chalos18/PROD385Project/images/climbing_wall.JPEG

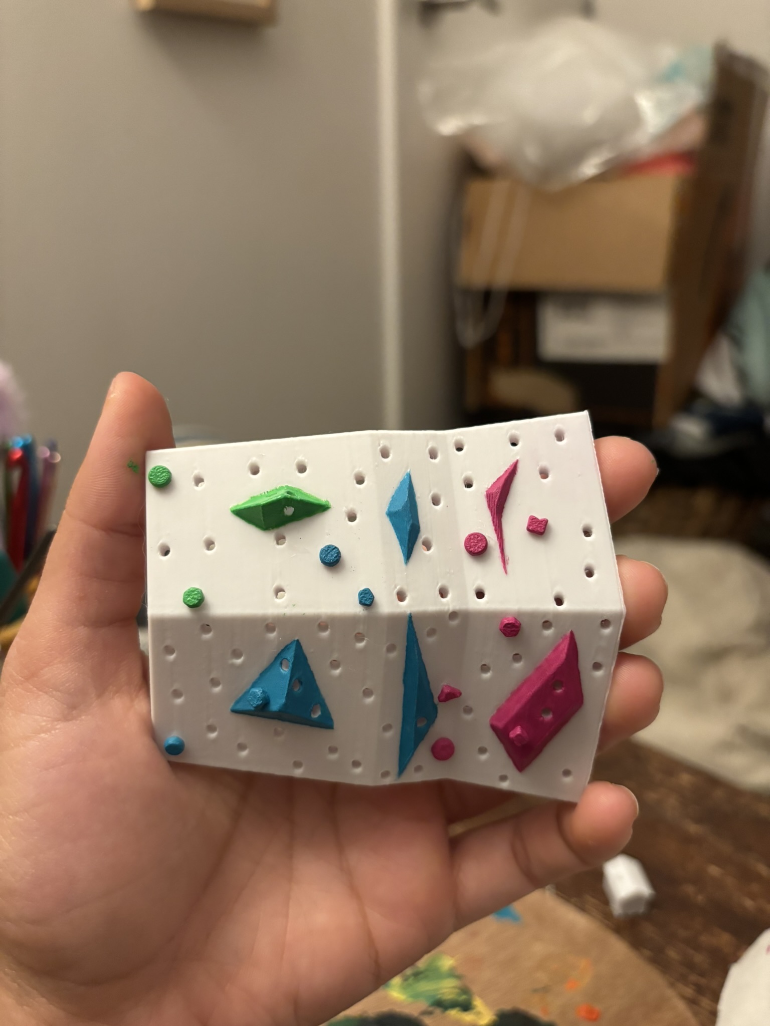
images/climbing_wall.JPEG
