chalos18/PROD385Project/images/lcd_hello.JPEG

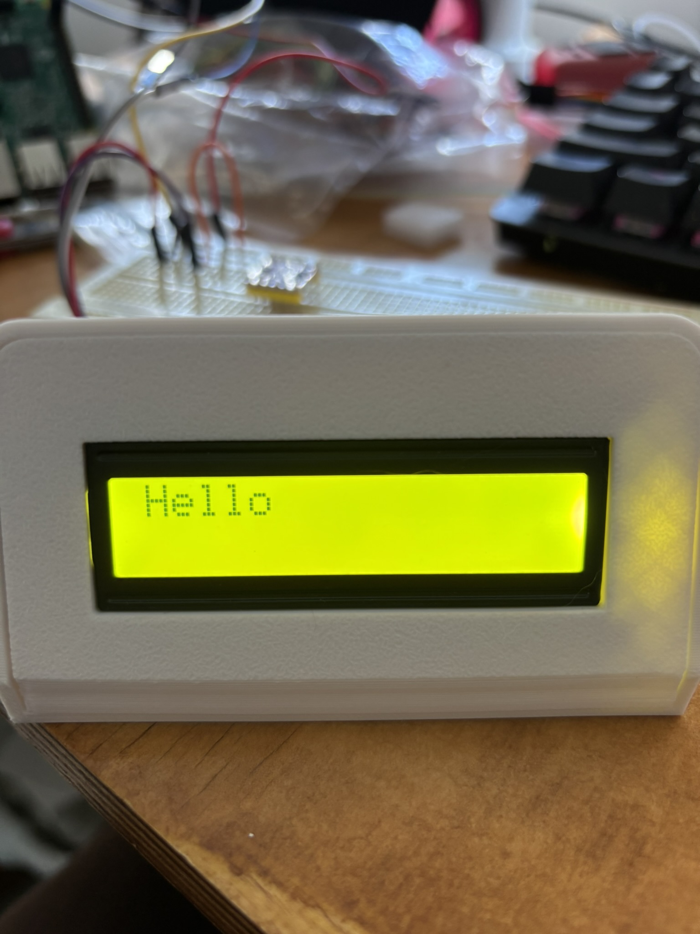
images/lcd_hello.JPEG
