chalos18/PROD385Project/images/LED_prototype_2.JPEG

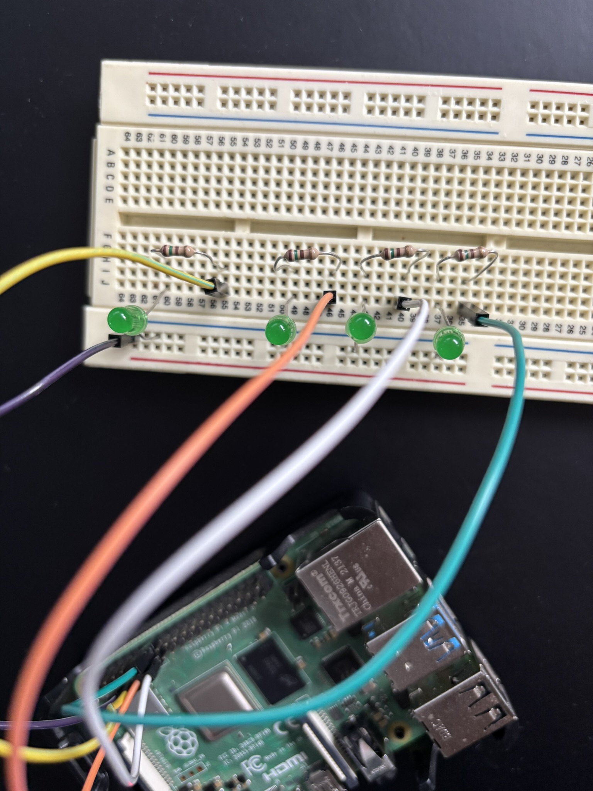
images/LED_prototype_2.JPEG
