chalos18/PROD385Project/images/PIR_ack.JPEG

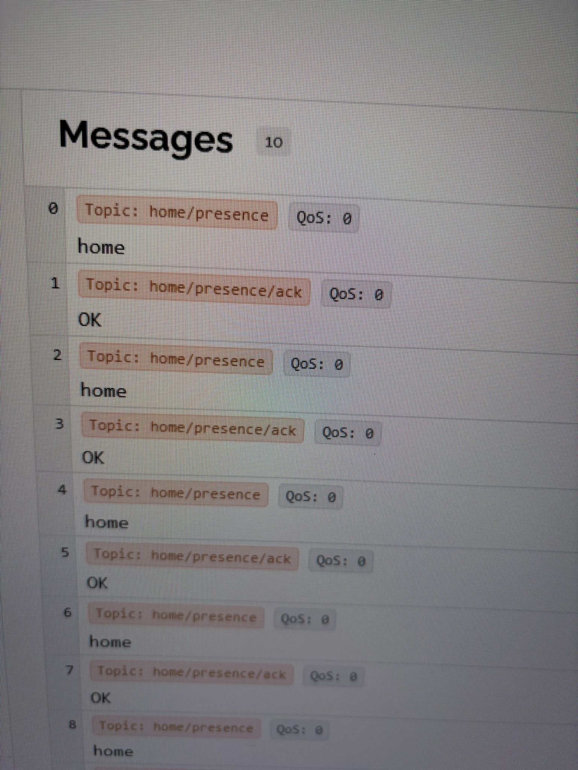
images/PIR_ack.JPEG
