chalos18/PROD385Project/images/PIR_sensor_demo.JPEG

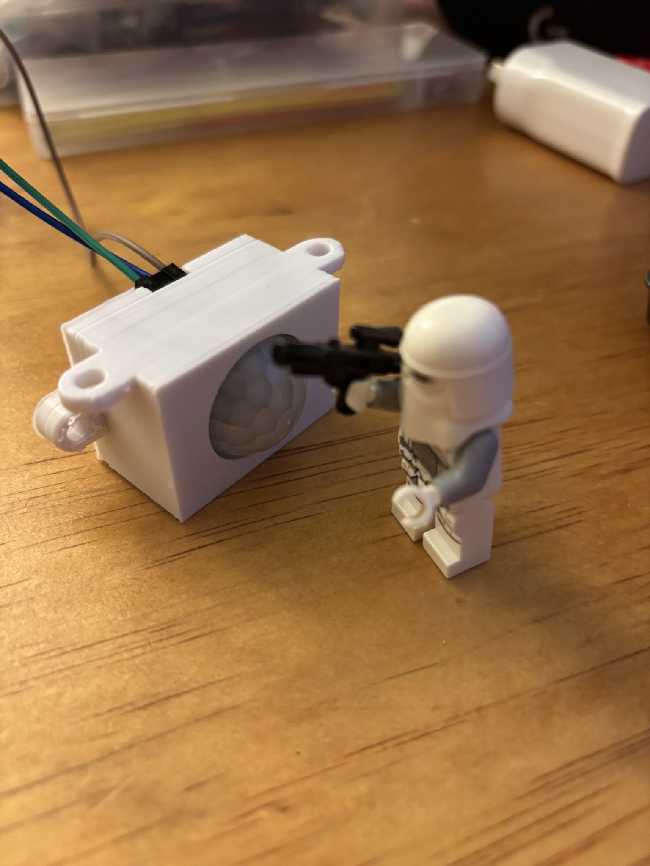
images/PIR_sensor_demo.JPEG
