chalos18/PROD385Project/(commit log)

2025-11-29 new LED flow and make simple MQTT circuit work
2025-12-12 update simple button workflow to contain 3 more leds
2025-12-12 build upon prototype workflow and add led logic
2025-12-12 update mqtt server connection for prototype
2026-01-08 new prototypes added, such as mqtt checks and servo workflows
2026-01-09 connected prototype workflow to home PIR
2026-01-17 added lcd i2c support
2026-01-20 Add flows_cred.json to .gitignore
2026-01-21 upload all my arduino sketches from the project
2026-01-21 Add a quick docs on things I learned when downloading a raspberry pi image, to go together with the README
